MartinProperzi/2026_2C_PF_CELDA-AUTOMATIZADA-DE-INYECCION-4.0_MALACHINA_PROPERZI/Codigo/robot XY/images/DrawingMachine00.png

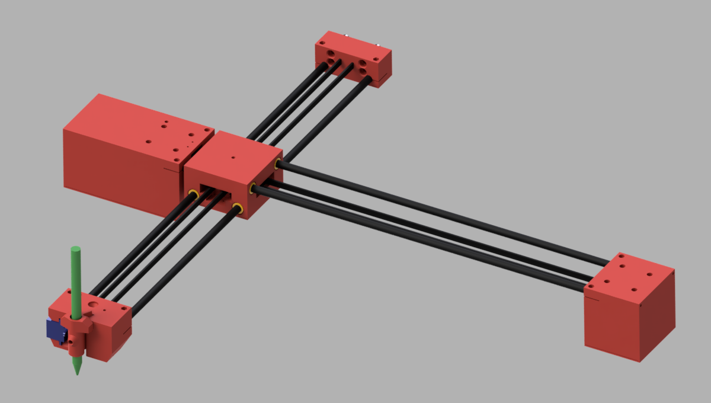
Codigo/robot XY/images/DrawingMachine00.png
