MartinProperzi/2026_2C_PF_CELDA-AUTOMATIZADA-DE-INYECCION-4.0_MALACHINA_PROPERZI/Multimedia (Imágenes y videos)/CIRCUITO ROBOT XY.png

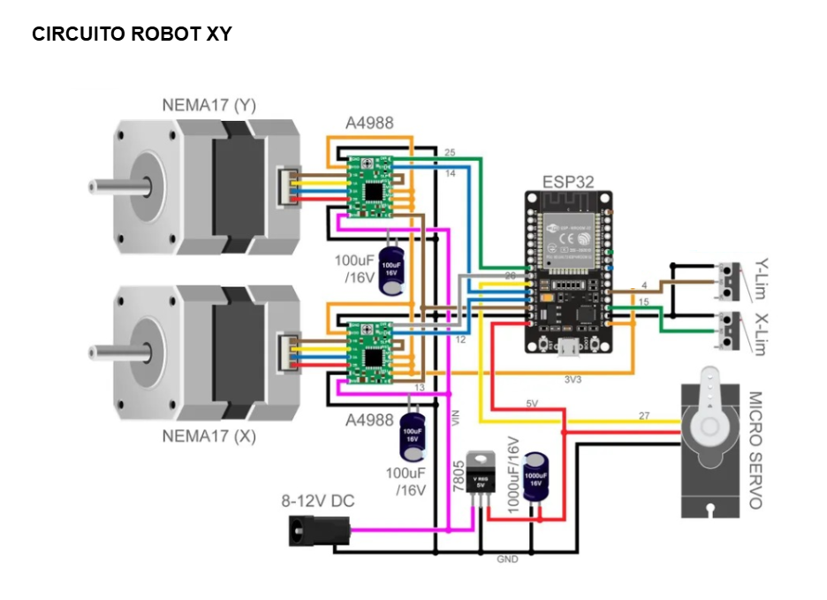
Multimedia (Imágenes y videos)/CIRCUITO ROBOT XY.png
