MartinProperzi/2026_2C_PF_CELDA-AUTOMATIZADA-DE-INYECCION-4.0_MALACHINA_PROPERZI/Codigo/robot XY/files/1x_CaseLarge.stl

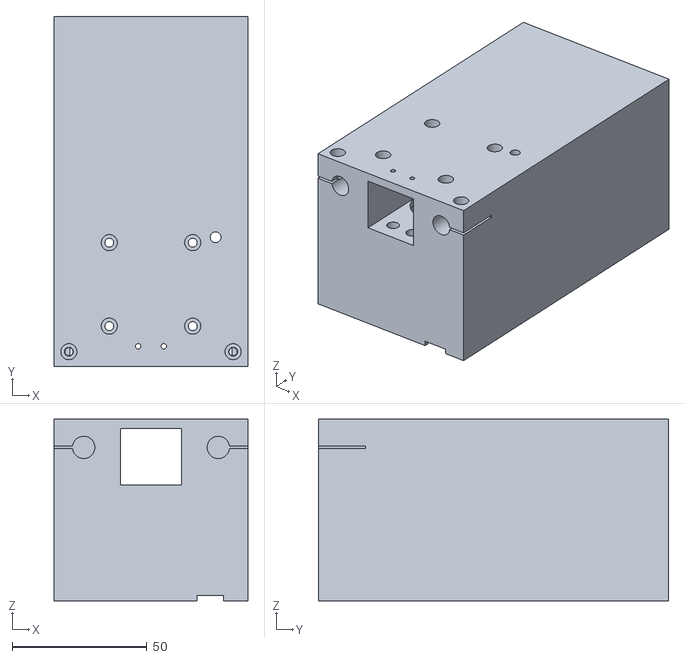
[picture p7: CAD file, 2026-10-26]
Codigo/robot XY/files/1x_CaseLarge.stl
72.0 x 130.0 x 67.5
