MartinProperzi/2026_2C_PF_CELDA-AUTOMATIZADA-DE-INYECCION-4.0_MALACHINA_PROPERZI/Codigo/robot XY/files/NO VAN/1x_SliderBottom.stl

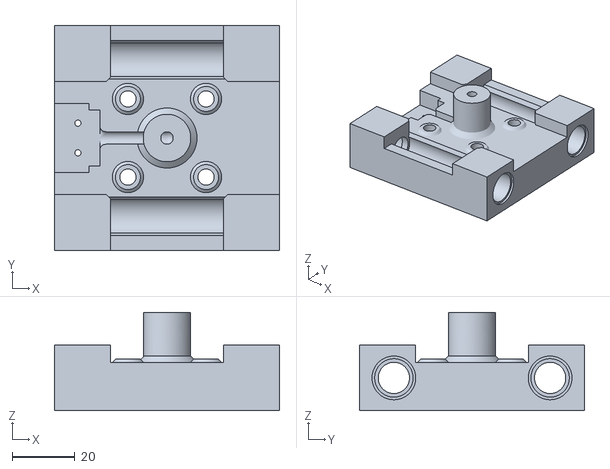
[picture p8: CAD file, 2026-10-26]
Codigo/robot XY/files/NO VAN/1x_SliderBottom.stl
72.0 x 72.0 x 31.5
