MartinProperzi/2026_2C_PF_CELDA-AUTOMATIZADA-DE-INYECCION-4.0_MALACHINA_PROPERZI/Codigo/robot XY/files/1x_CaseLargeCover.stl

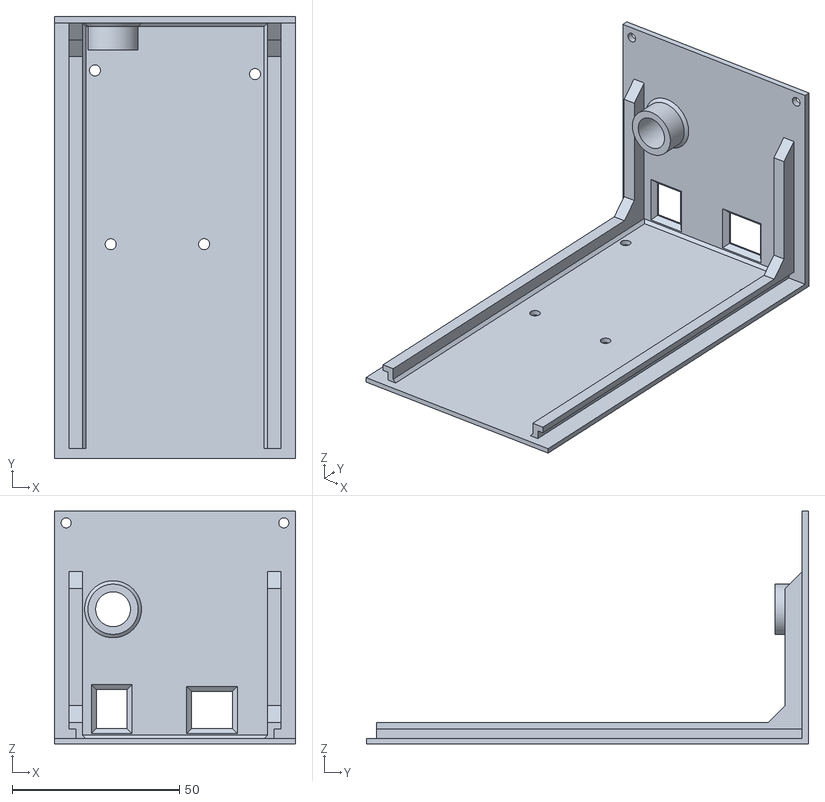
[picture p9: CAD file, 2026-10-26]
Codigo/robot XY/files/1x_CaseLargeCover.stl
72.0 x 132.0 x 69.5
