MartinProperzi/2026_2C_PF_CELDA-AUTOMATIZADA-DE-INYECCION-4.0_MALACHINA_PROPERZI/Codigo/robot XY/files/NO VAN/All.stl

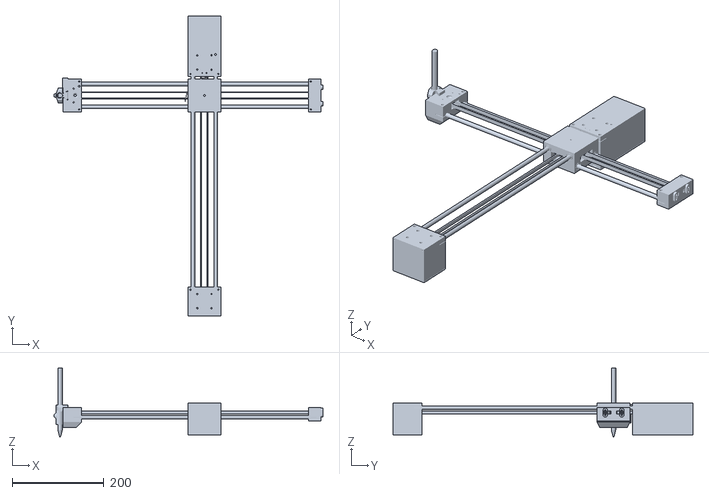
[picture p10: CAD file, 2026-10-26]
Codigo/robot XY/files/NO VAN/All.stl
586.4 x 655.0 x 150.0
