MartinProperzi/2026_2C_PF_CELDA-AUTOMATIZADA-DE-INYECCION-4.0_MALACHINA_PROPERZI/Codigo/robot XY/files/1x_SliderTop modificado.stl

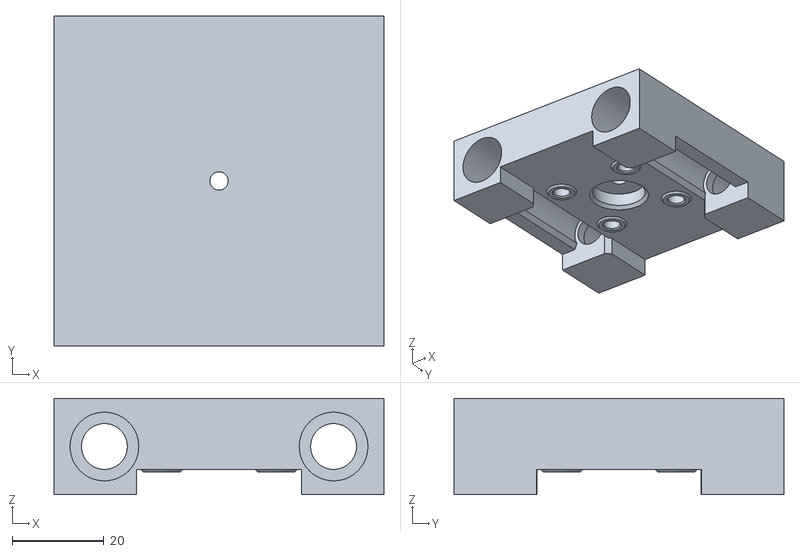
[picture p11: CAD file, 2026-10-26]
Codigo/robot XY/files/1x_SliderTop modificado.stl
72.0 x 72.0 x 21.0
