MartinProperzi/2026_2C_PF_CELDA-AUTOMATIZADA-DE-INYECCION-4.0_MALACHINA_PROPERZI/Codigo/robot XY/files/NO VAN/1x_FrontPenHolder.stl

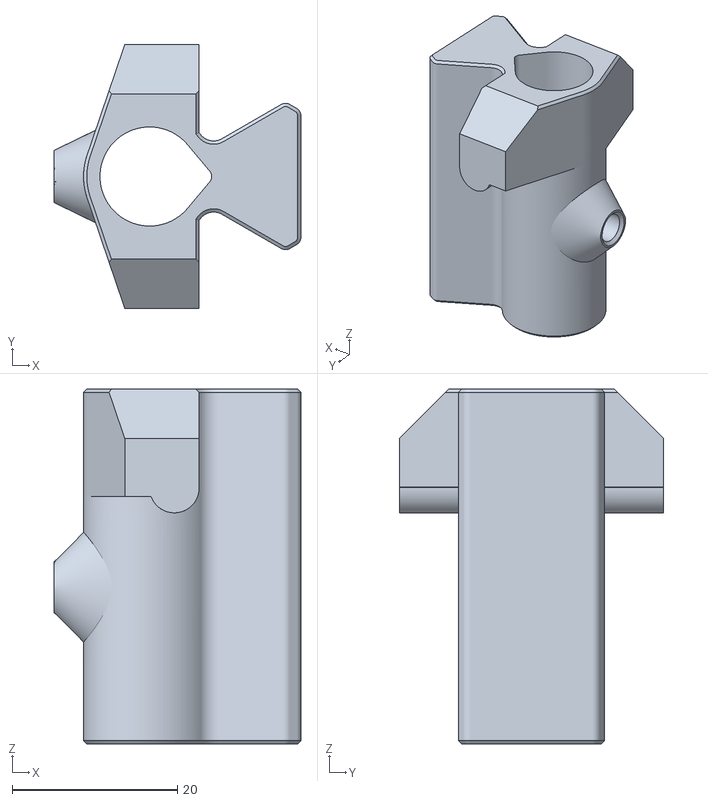
[picture p12: CAD file, 2026-10-26]
Codigo/robot XY/files/NO VAN/1x_FrontPenHolder.stl
29.9 x 32.0 x 43.0
