MartinProperzi/2026_2C_PF_CELDA-AUTOMATIZADA-DE-INYECCION-4.0_MALACHINA_PROPERZI/Codigo/robot XY/files/1x_Front.stl

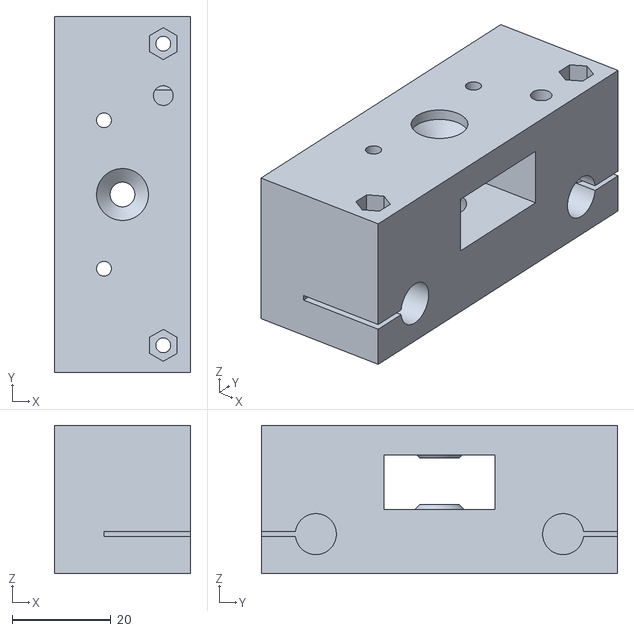
[picture p13: CAD file, 2026-10-26]
Codigo/robot XY/files/1x_Front.stl
27.5 x 72.0 x 30.0
