MartinProperzi/2026_2C_PF_CELDA-AUTOMATIZADA-DE-INYECCION-4.0_MALACHINA_PROPERZI/Codigo/robot XY/files/2x_RearBeltClamp.stl

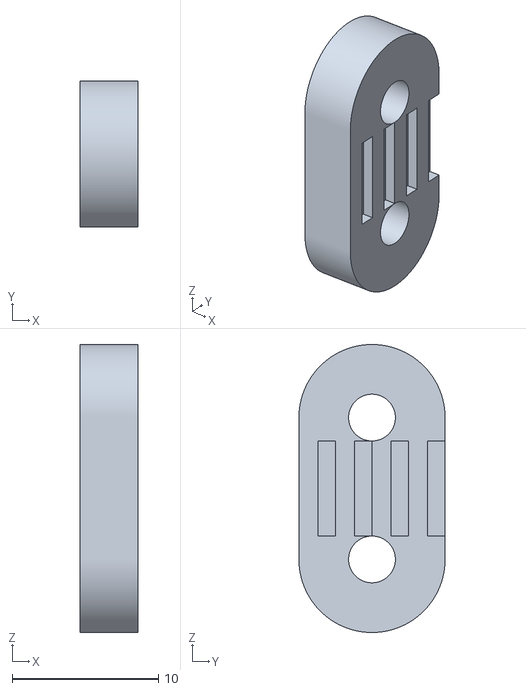
[picture p15: CAD file, 2026-10-26]
Codigo/robot XY/files/2x_RearBeltClamp.stl
4.00 x 10.0 x 19.7
