MartinProperzi/2026_2C_PF_CELDA-AUTOMATIZADA-DE-INYECCION-4.0_MALACHINA_PROPERZI/Codigo/robot XY/files/NO VAN/1x_FrontServoHolder.stl

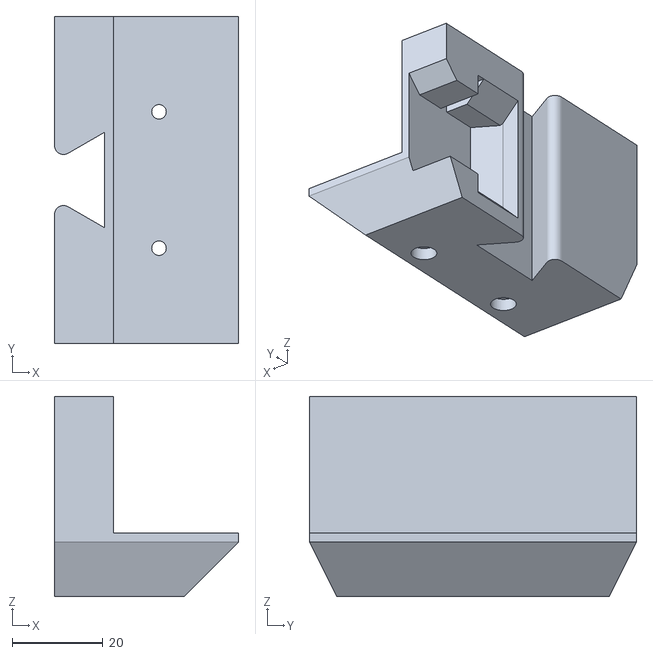
[picture p16: CAD file, 2026-10-26]
Codigo/robot XY/files/NO VAN/1x_FrontServoHolder.stl
40.5 x 72.0 x 44.0
