MartinProperzi/2026_2C_PF_CELDA-AUTOMATIZADA-DE-INYECCION-4.0_MALACHINA_PROPERZI/Codigo/robot XY/files/1x_slider bottom modificado.stl

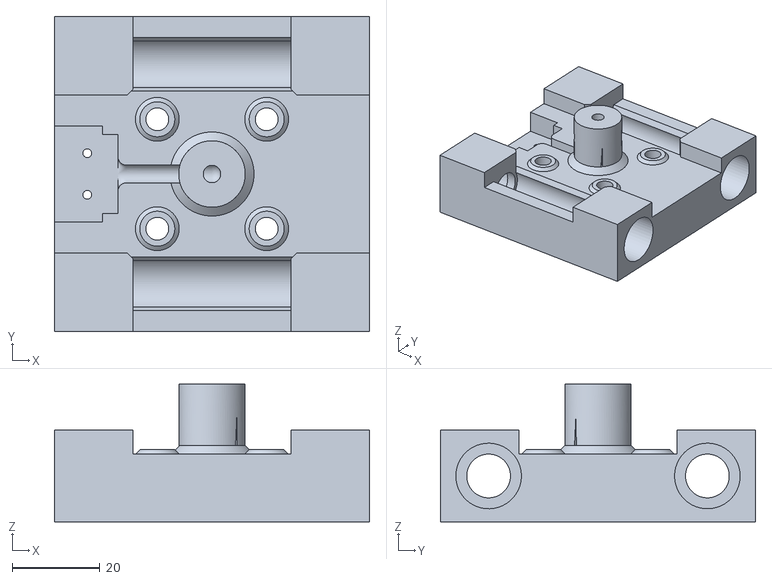
[picture p17: CAD file, 2026-10-26]
Codigo/robot XY/files/1x_slider bottom modificado.stl
72.0 x 72.0 x 31.5
