MartinProperzi/2026_2C_PF_CELDA-AUTOMATIZADA-DE-INYECCION-4.0_MALACHINA_PROPERZI/Codigo/robot XY/files/NO VAN/8x_BearingCover.stl

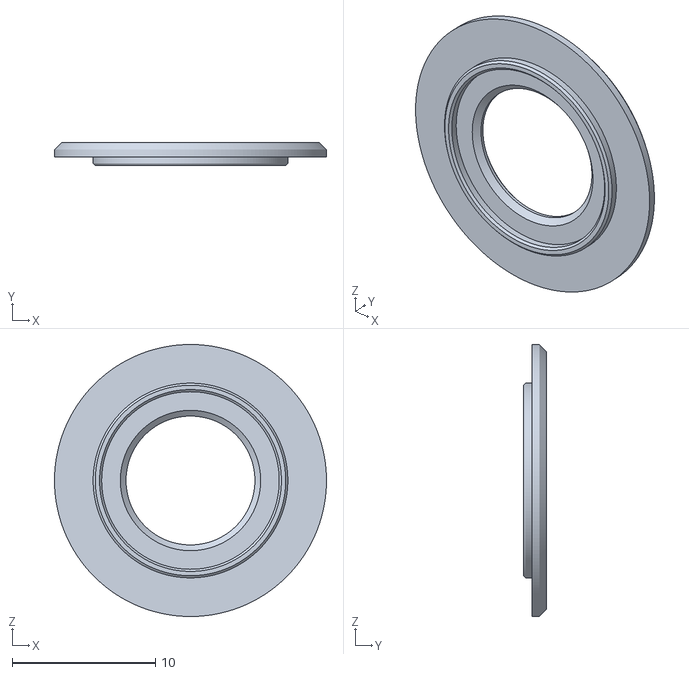
[picture p18: CAD file, 2026-10-26]
Codigo/robot XY/files/NO VAN/8x_BearingCover.stl
19.0 x 1.60 x 19.0
