MartinProperzi/2026_2C_PF_CELDA-AUTOMATIZADA-DE-INYECCION-4.0_MALACHINA_PROPERZI/Codigo/robot XY/files/1x_CaseSmallCover.stl

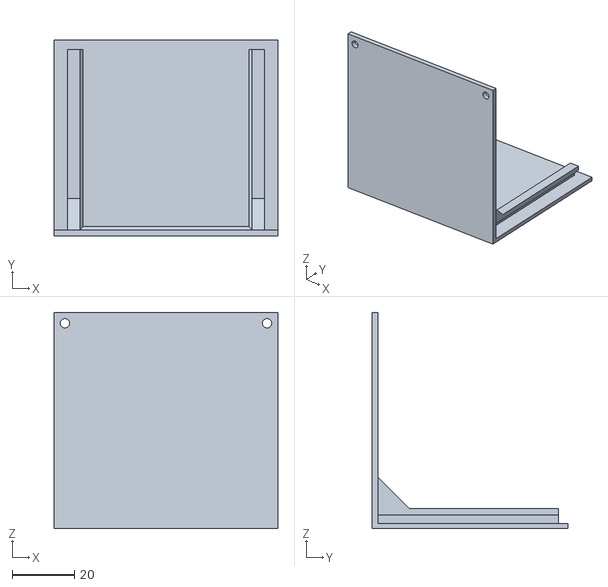
[picture p20: CAD file, 2026-10-26]
Codigo/robot XY/files/1x_CaseSmallCover.stl
72.0 x 63.0 x 69.5
