MartinProperzi/2026_2C_PF_CELDA-AUTOMATIZADA-DE-INYECCION-4.0_MALACHINA_PROPERZI/(list of files, cad)

Other CAD files:
Codigo/robot XY/files/1x_Rear.stl
