MartinProperzi/2026_2C_PF_CELDA-AUTOMATIZADA-DE-INYECCION-4.0_MALACHINA_PROPERZI/Informes (GANTT, INFORME PDF, CRONOGRAMAS, MANUALES)/GANTT.png

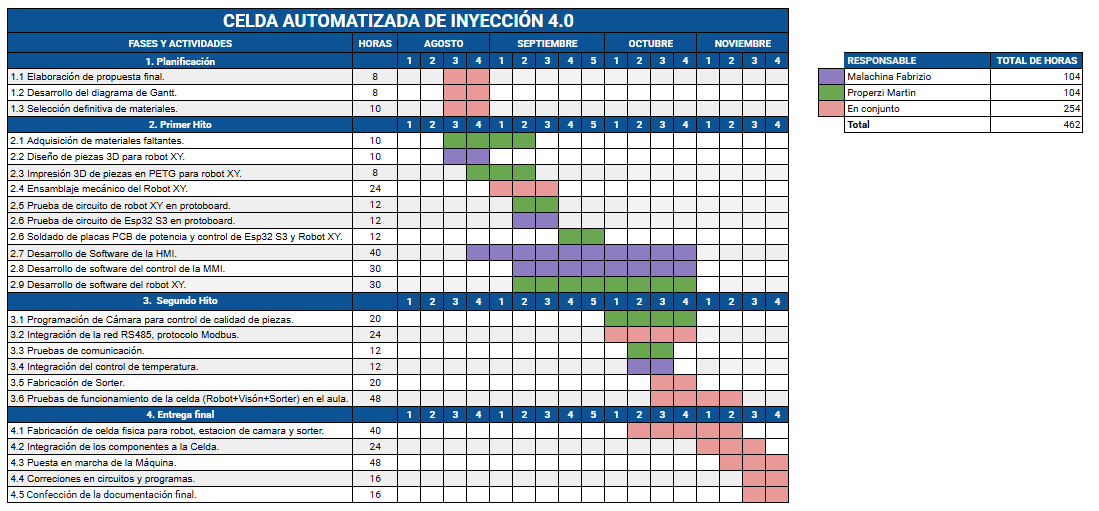
Informes (GANTT, INFORME PDF, CRONOGRAMAS, MANUALES)/GANTT.png
