MartinProperzi/2026_2C_PF_CELDA-AUTOMATIZADA-DE-INYECCION-4.0_MALACHINA_PROPERZI/Codigo/MMI-S3/MMI_S3_Robot_FreeRTOS/MMI_S3_Robot_FreeRTOS/MachineData.h

#pragma once
#include <Arduino.h>
#include "freertos/FreeRTOS.h"
#include "freertos/semphr.h"

#define MB_REGS 26

enum ModbusRegisters {
  MB_SENSORES = 0,
  MB_HMI_BOTONES,
  MB_SDIGITALES,
  MB_CONTROL,
  MB_TESPERA,
  MB_TESPERAI,
  MB_TINYECCION,
  MB_TINYECCIONI,
  MB_TSOSTENIMIENTO,
  MB_TSOSTENIMIENTOI,
  MB_TENFRIAMIENTO,
  MB_TENFRIAMIENTOI,
  MB_TEXP_AVANCE,
  MB_TEXP_AVANCEI,
  MB_TEXP_RETROCESO,
  MB_TEXP_RETROCESOI,
  MB_TEMPZ1,
  MB_SETPOINTZ1,
  MB_TEMPZ2,
  MB_SETPOINTZ2,
  MB_TEMPZ3,
  MB_SETPOINTZ3,
  MB_HISTERESIS,
  MB_TOTAL_PIEZAS,
  MB_TIEMPO_CICLO,
  MB_PASO_ACTUAL
};

struct MachineState {
  uint16_t regs[MB_REGS];
  bool ciclo_activo;
  int paso_actual;
  bool estado_emergencia;
  bool aux_gh;
  bool aux_gl;
  bool robot_permite_cierre;
  bool robot_pide_expulsor_adelante;
  bool robot_pide_expulsor_atras;
};

extern MachineState PLC;
extern SemaphoreHandle_t plc_mutex;

inline void PLC_Lock() {
  if (plc_mutex != NULL) xSemaphoreTake(plc_mutex, portMAX_DELAY);
}

inline void PLC_Unlock() {
  if (plc_mutex != NULL) xSemaphoreGive(plc_mutex);
}
