MartinProperzi/2026_2C_PF_CELDA-AUTOMATIZADA-DE-INYECCION-4.0_MALACHINA_PROPERZI/Codigo/MMI-S3/MMI_S3_Robot_FreeRTOS/MMI_S3_Robot_FreeRTOS/RobotManager.cpp

#include "RobotManager.h"
#include "MachineData.h"
#include <Arduino.h>

void RobotManager_Init() {
  PLC.robot_permite_cierre = false;
  PLC.robot_pide_expulsor_adelante = false;
  PLC.robot_pide_expulsor_atras = false;
}

void RobotManager_Update() {
  if (bitRead(PLC.regs[MB_CONTROL], 4) == 1) {
    PLC.robot_permite_cierre = true;
    bitWrite(PLC.regs[MB_CONTROL], 4, 0);
  }
  if (bitRead(PLC.regs[MB_CONTROL], 10) == 1) {
    PLC.robot_pide_expulsor_adelante = true;
    bitWrite(PLC.regs[MB_CONTROL], 10, 0);
  }
  if (bitRead(PLC.regs[MB_CONTROL], 11) == 1) {
    PLC.robot_pide_expulsor_atras = true;
    bitWrite(PLC.regs[MB_CONTROL], 11, 0);
  }
}
