MartinProperzi/2026_2C_PF_CELDA-AUTOMATIZADA-DE-INYECCION-4.0_MALACHINA_PROPERZI/Codigo/HMI/Versiones_Anteriores/esp32p4_lvgl_v9/lvgl_port_v9.h

/*
 * SPDX-FileCopyrightText: 2023-2024 Espressif Systems (Shanghai) CO LTD
 *
 * SPDX-License-Identifier: Apache-2.0
 */

#pragma once

#include <stdint.h>

#include "esp_err.h"
#include "esp_lcd_types.h"
#include "src/touch/esp_lcd_touch.h"
#include "lvgl.h"

#ifdef __cplusplus
extern "C" {
#endif

/**
 * @brief LVGL port interface type
 *
 */
typedef enum {
    LVGL_PORT_INTERFACE_RGB,
    LVGL_PORT_INTERFACE_MIPI_DSI_DMA,
    LVGL_PORT_INTERFACE_MIPI_DSI_NO_DMA,
    LVGL_PORT_INTERFACE_MAX,
} lvgl_port_interface_t;

/**
 * LVGL related parameters, can be adjusted by users
 *
 */
#define LVGL_PORT_H_RES             (1280)
#define LVGL_PORT_V_RES             (800)
#define LVGL_PORT_TICK_PERIOD_MS    (5)

/**
 * LVGL timer handle task related parameters, can be adjusted by users
 *
 */
#define LVGL_PORT_TASK_MAX_DELAY_MS (100)    // The maximum delay of the LVGL timer task, in milliseconds
#define LVGL_PORT_TASK_MIN_DELAY_MS (5)    // The minimum delay of the LVGL timer task, in milliseconds
#define LVGL_PORT_TASK_STACK_SIZE   (8 * 1024) // The stack size of the LVGL timer task, in bytes
#define LVGL_PORT_TASK_PRIORITY     (4)        // The priority of the LVGL timer task
#define LVGL_PORT_TASK_CORE         (1)            // The core of the LVGL timer task,
// `-1` means the don't specify the core
/**
 *
 * LVGL buffer related parameters, can be adjusted by users:
 *  (These parameters will be useless if the avoid tearing function is enabled)
 *
 *  - Memory type for buffer allocation:
 *      - MALLOC_CAP_SPIRAM: Allocate LVGL buffer in PSRAM
 *      - MALLOC_CAP_INTERNAL: Allocate LVGL buffer in SRAM
 *      (The SRAM is faster than PSRAM, but the PSRAM has a larger capacity)
 *
 */
#if CONFIG_EXAMPLE_LVGL_PORT_BUF_PSRAM
#define LVGL_PORT_BUFFER_MALLOC_CAPS    (MALLOC_CAP_SPIRAM)
#elif CONFIG_EXAMPLE_LVGL_PORT_BUF_INTERNAL
// Asegura que use la PSRAM para los búferes gráficos de manera directa
#define LVGL_PORT_BUFFER_MALLOC_CAPS    (MALLOC_CAP_SPIRAM)
#endif
#define LVGL_PORT_BUFFER_HEIGHT         (100)

/**
 * Avoid tering related configurations, can be adjusted by users.
 *
 */
#define LVGL_PORT_AVOID_TEAR_ENABLE     (1) // Set to 1 to enable
#if LVGL_PORT_AVOID_TEAR_ENABLE
/**
 * Set the avoid tearing mode:
 *      - 0: Disable avoid tearing function
 *      - 1: LCD double-buffer & LVGL full-refresh
 *      - 2: LCD triple-buffer & LVGL full-refresh
 *      - 3: LCD double-buffer & LVGL direct-mode (recommended)
 *
 */
#define LVGL_PORT_AVOID_TEAR_MODE       (3)

/**
 * Set the PPA rotation enable:
 *      - 0: Disable PPA rotation
 *      - 1: Enable PPA rotation
 *
 */
#define LVGL_PORT_PPA_ROTATION_ENABLE   (0)

/**
 * Set the rotation degree of the LCD panel when the avoid tearing function is enabled:
 *      - 0: 0 degree
 *      - 90: 90 degree
 *      - 180: 180 degree
 *      - 270: 270 degree
 *
 */
#define EXAMPLE_LVGL_PORT_ROTATION_DEGREE  (0)

/**
 * Below configurations are automatically set according to the above configurations, users do not need to modify them.
 *
 */
#if LVGL_PORT_AVOID_TEAR_MODE == 1
#define LVGL_PORT_LCD_BUFFER_NUMS   (2)
#define LVGL_PORT_FULL_REFRESH          (1)
#elif LVGL_PORT_AVOID_TEAR_MODE == 2
#define LVGL_PORT_LCD_BUFFER_NUMS   (3)
#define LVGL_PORT_FULL_REFRESH          (1)
#elif LVGL_PORT_AVOID_TEAR_MODE == 3
#define LVGL_PORT_LCD_BUFFER_NUMS   (2)
#define LVGL_PORT_DIRECT_MODE           (1)
#endif /* LVGL_PORT_AVOID_TEAR_MODE */

#if EXAMPLE_LVGL_PORT_ROTATION_DEGREE == 0
#define EXAMPLE_LVGL_PORT_ROTATION_0    (1)
#else
#if EXAMPLE_LVGL_PORT_ROTATION_DEGREE == 90
#define EXAMPLE_LVGL_PORT_ROTATION_90   (1)
#elif EXAMPLE_LVGL_PORT_ROTATION_DEGREE == 180
#define EXAMPLE_LVGL_PORT_ROTATION_180  (1)
#elif EXAMPLE_LVGL_PORT_ROTATION_DEGREE == 270
#define EXAMPLE_LVGL_PORT_ROTATION_270  (1)
#endif
#ifdef LVGL_PORT_LCD_BUFFER_NUMS
#undef LVGL_PORT_LCD_BUFFER_NUMS
#define LVGL_PORT_LCD_BUFFER_NUMS   (3)
#endif
#endif /* EXAMPLE_LVGL_PORT_ROTATION_DEGREE */
#else
#define LVGL_PORT_LCD_BUFFER_NUMS   (1)
#define LVGL_PORT_FULL_REFRESH          (0)
#define LVGL_PORT_DIRECT_MODE           (0)
#endif /* LVGL_PORT_AVOID_TEAR_ENABLE */

/**
 * @brief Initialize LVGL port
 *
 * @param[in] lcd_handle: LCD panel handle
 * @param[in] tp_handle: Touch panel handle
 *
 * @return
 *      - ESP_OK: Success
 *      - ESP_ERR_INVALID_ARG: Invalid argument
 *      - Others: Fail
 */
esp_err_t lvgl_port_init(esp_lcd_panel_handle_t lcd_handle, esp_lcd_touch_handle_t tp_handle, lvgl_port_interface_t interface);

/**
 * @brief Take LVGL mutex
 *
 * @param[in] timeout_ms: Timeout in [ms]. 0 will block indefinitely.
 *
 * @return
 *      - true:  Mutex was taken
 *      - false: Mutex was NOT taken
 */
bool lvgl_port_lock(int timeout_ms);

/**
 * @brief Give LVGL mutex
 *
 */
void lvgl_port_unlock(void);

/**
 * @brief Notifies the LVGL task when the transmission of the RGB frame buffer is completed.
 *
 * @return
 *      - true:  The tasks need to be re-scheduled
 *      - false: The tasks don't need to be re-scheduled
 */
bool lvgl_port_notify_lcd_vsync(void);

void lvgl_sw_rotation(void);

#ifdef __cplusplus
}
#endif
